raphatex/handheld-chip-8/README.md

# handheld-chip-8
on créé une console portable chip 8
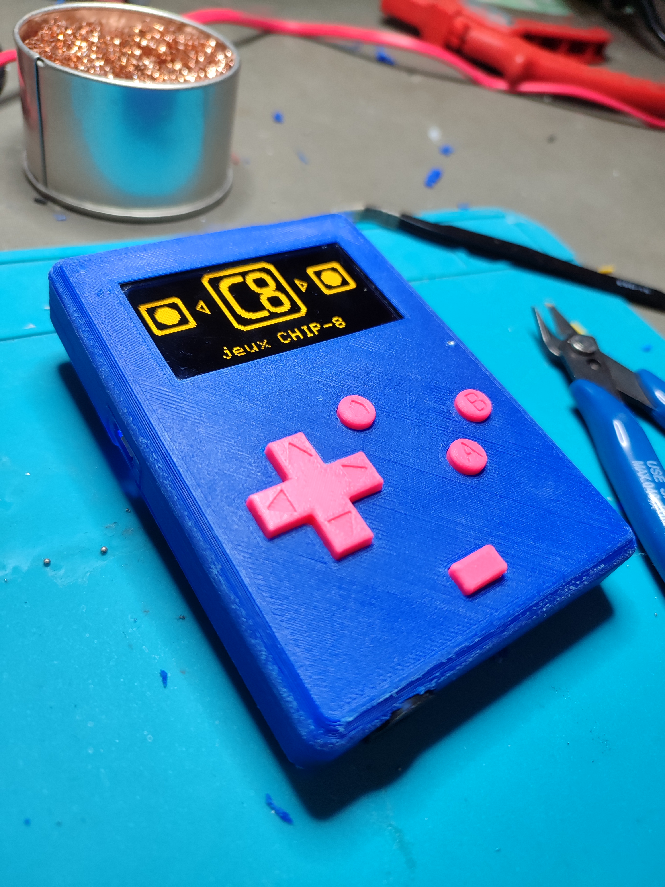
[picture p1: face_avant.jpg]

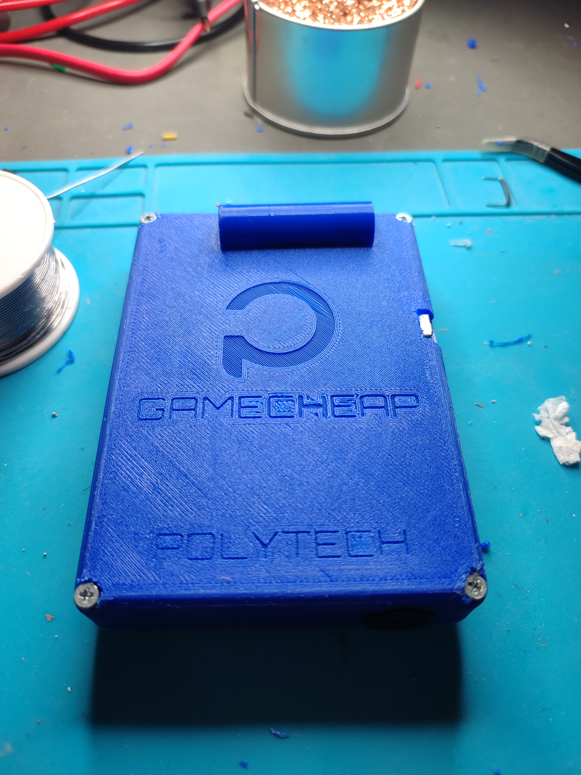
[picture p2: face_arriere.jpg]
