raphatex/handheld-chip-8/doc/photos/1706565870009.jpg

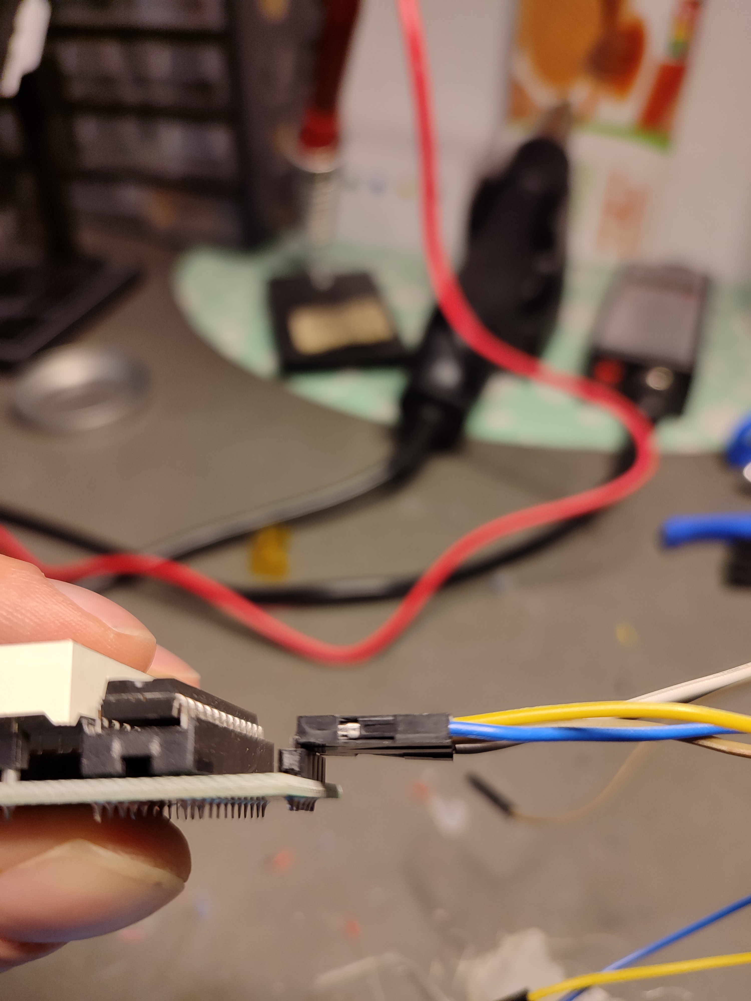
doc/photos/1706565870009.jpg
