raphatex/handheld-chip-8/doc/photos/1706565870017.jpg

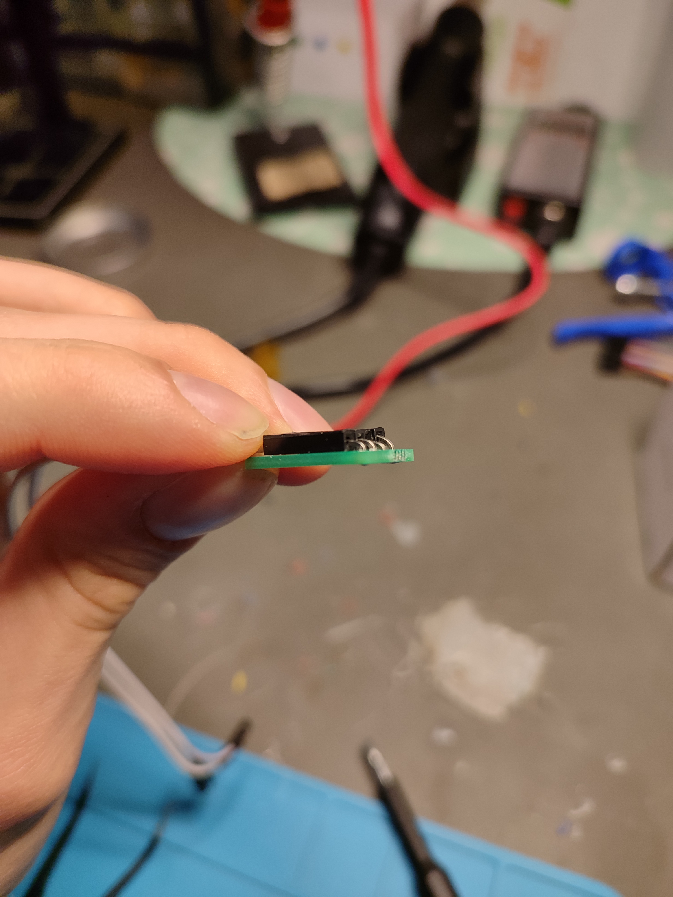
doc/photos/1706565870017.jpg
