raphatex/handheld-chip-8/doc/photos/1706565870035.jpg

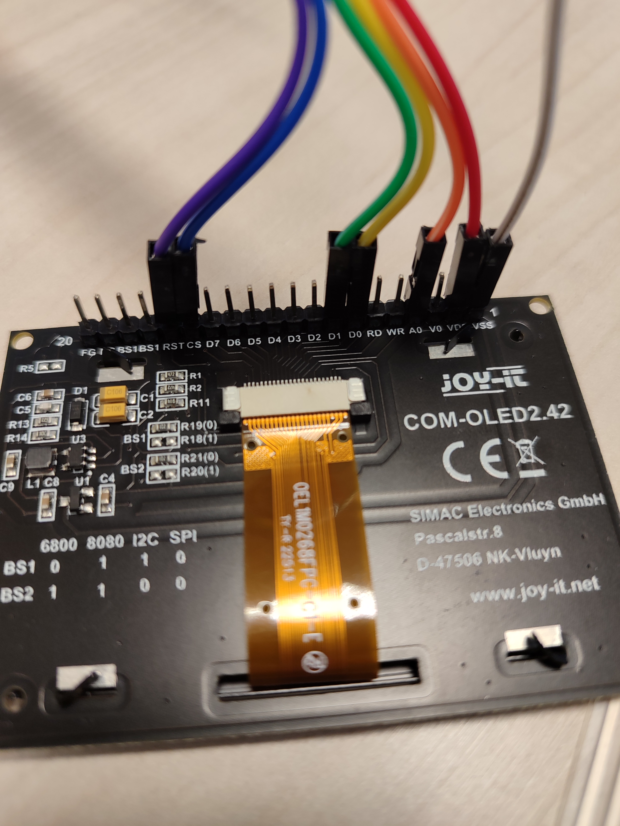
doc/photos/1706565870035.jpg
