raphatex/handheld-chip-8/doc/photos/1707742861026.jpg

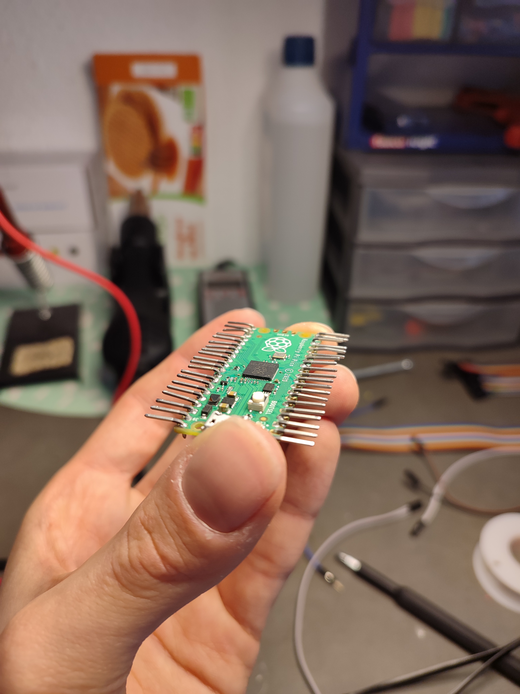
doc/photos/1707742861026.jpg
