raphatex/handheld-chip-8/doc/photos/1707742861034.jpg

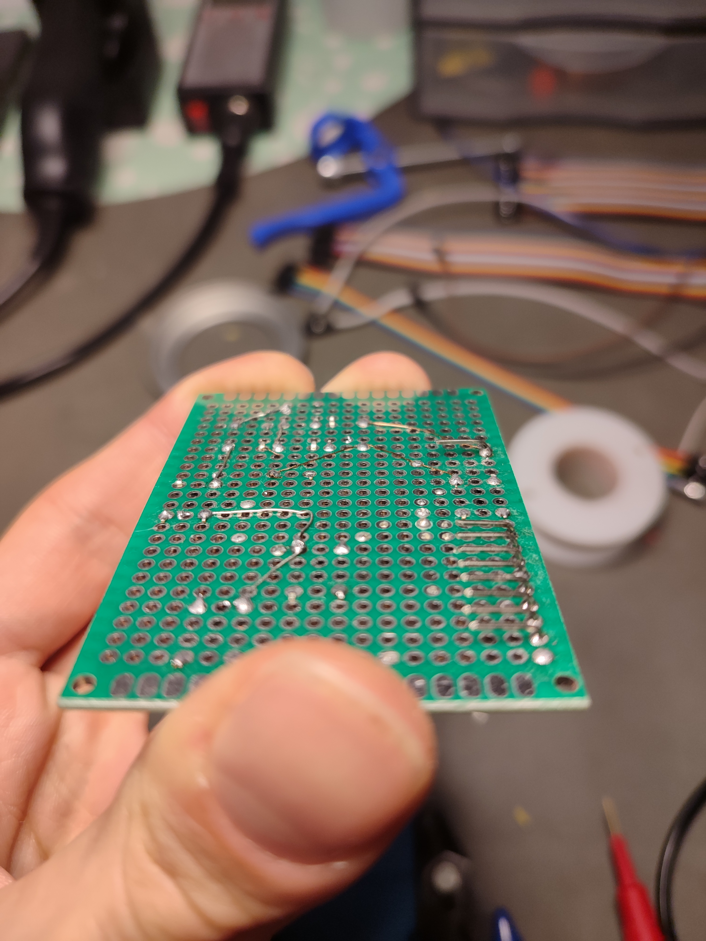
doc/photos/1707742861034.jpg
