raphatex/handheld-chip-8/doc/photos/1707742861042.jpg

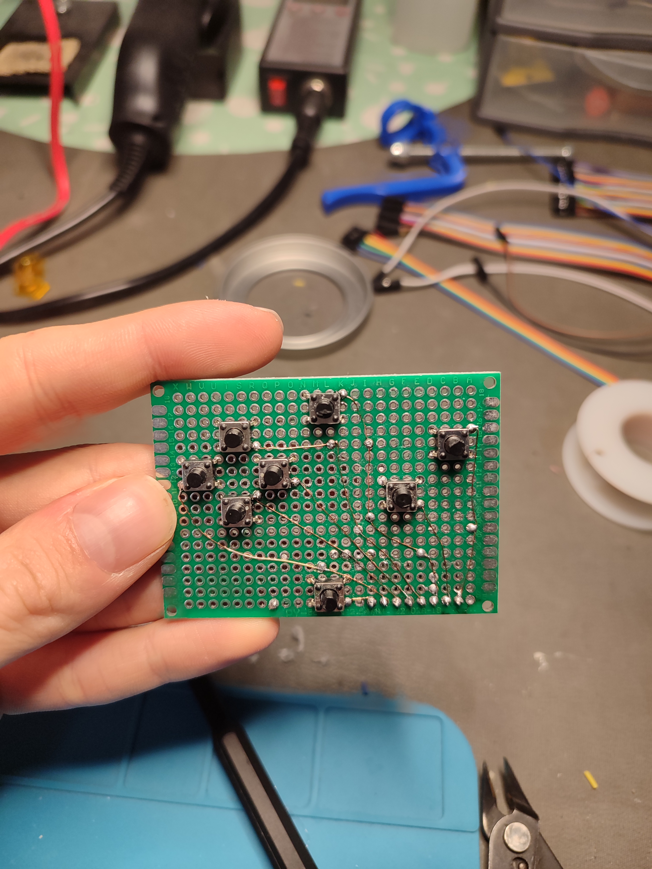
doc/photos/1707742861042.jpg
