raphatex/handheld-chip-8/doc/photos/1710105223419.jpg

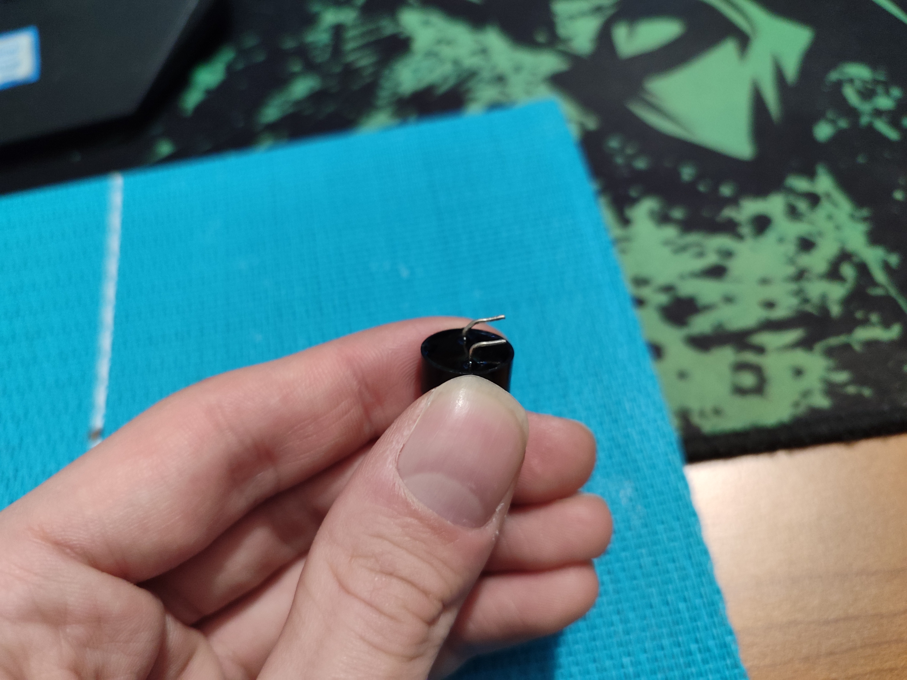
doc/photos/1710105223419.jpg
