raphatex/handheld-chip-8/doc/photos/1710105223430.jpg

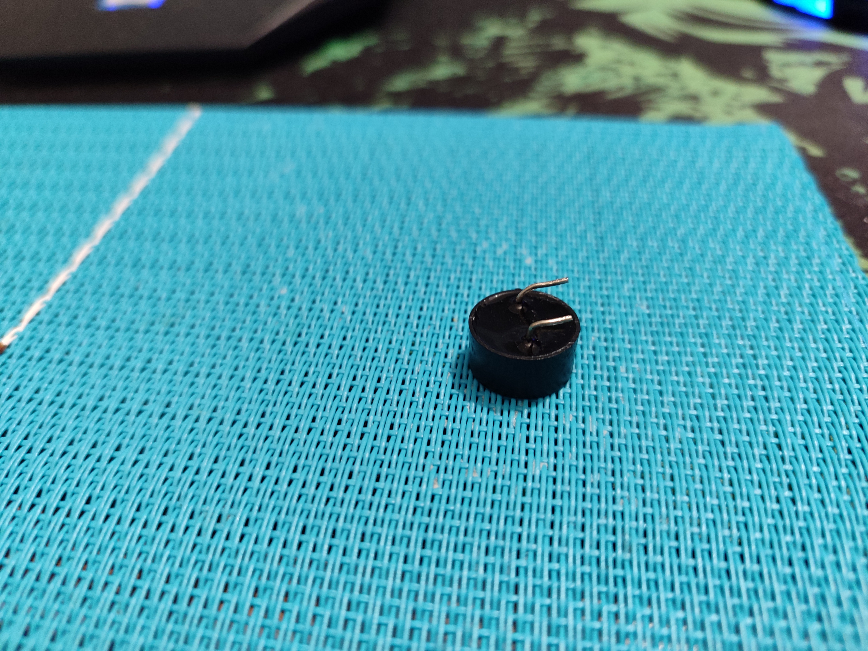
doc/photos/1710105223430.jpg
