raphatex/handheld-chip-8/doc/photos/1710105223459.jpg

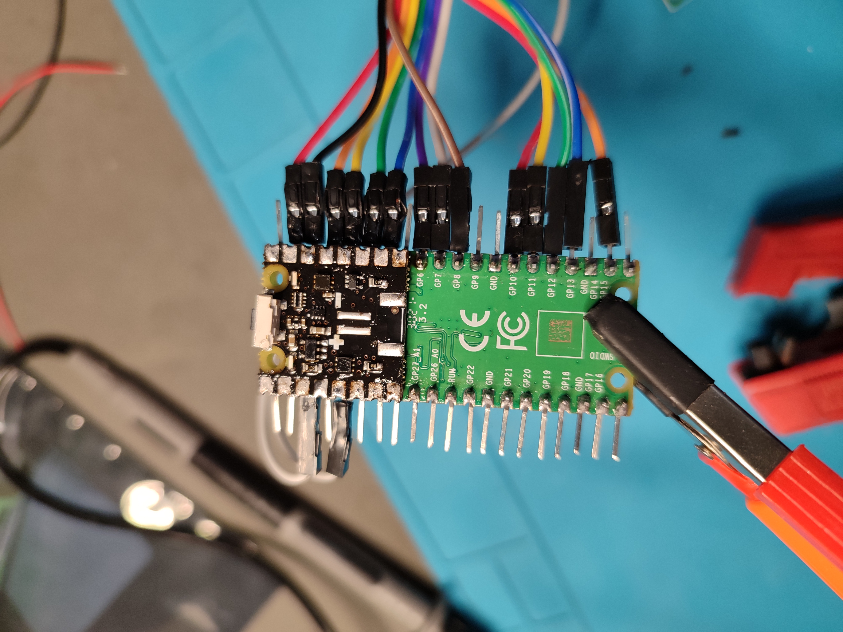
doc/photos/1710105223459.jpg
