raphatex/handheld-chip-8/doc/photos/1710794936792.jpg

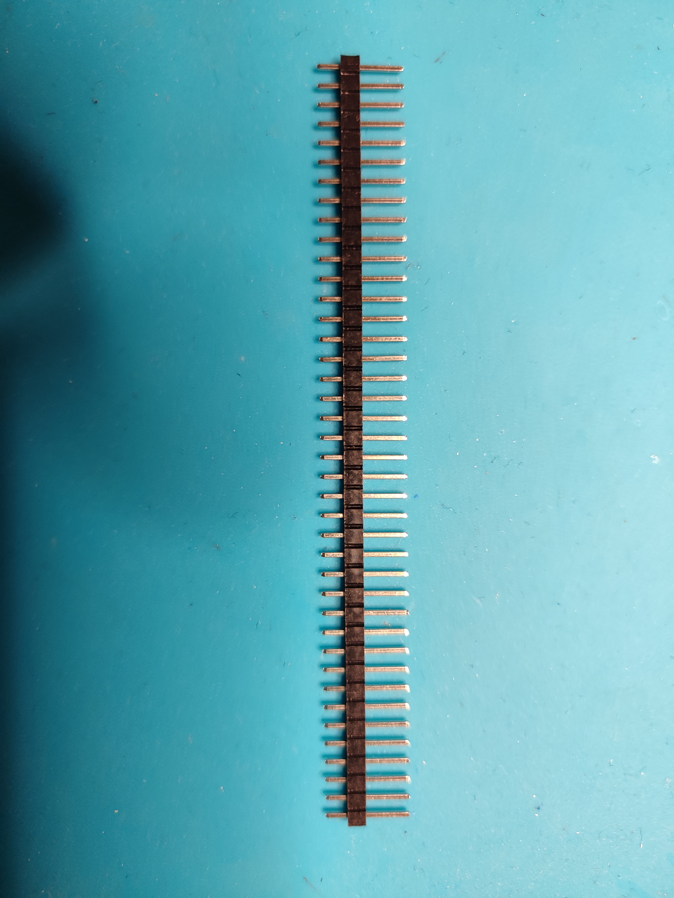
doc/photos/1710794936792.jpg
