raphatex/handheld-chip-8/doc/photos/1710794976683.jpg

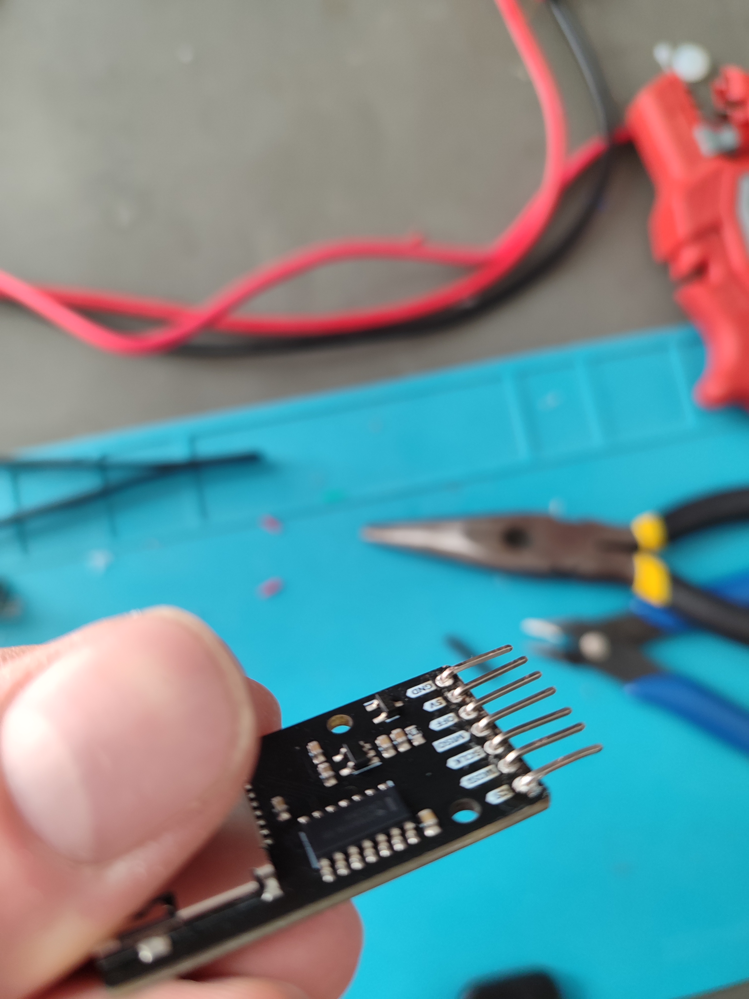
doc/photos/1710794976683.jpg
