raphatex/handheld-chip-8/doc/photos/1710794976693.jpg

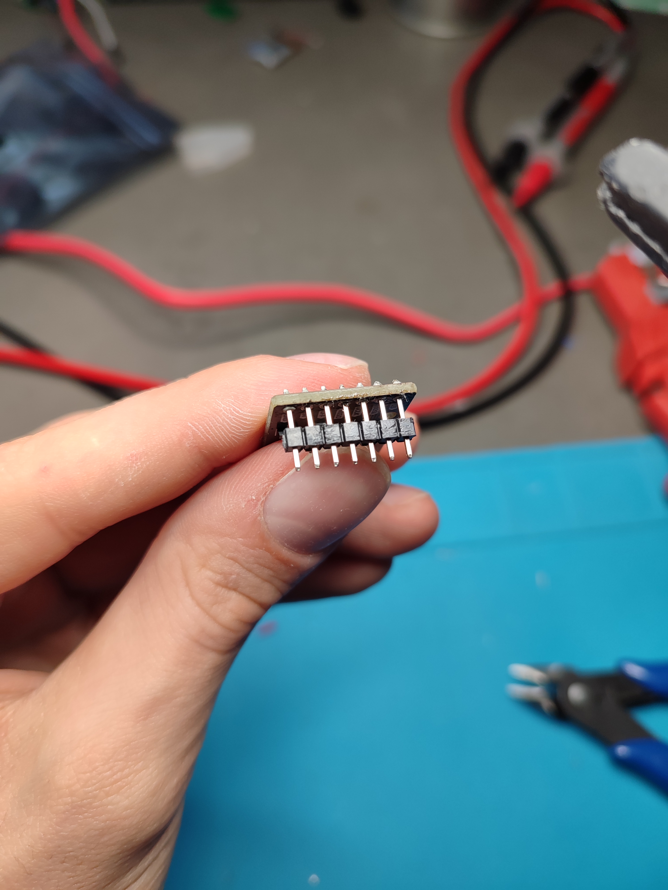
doc/photos/1710794976693.jpg
