raphatex/handheld-chip-8/doc/photos/1710794976715.jpg

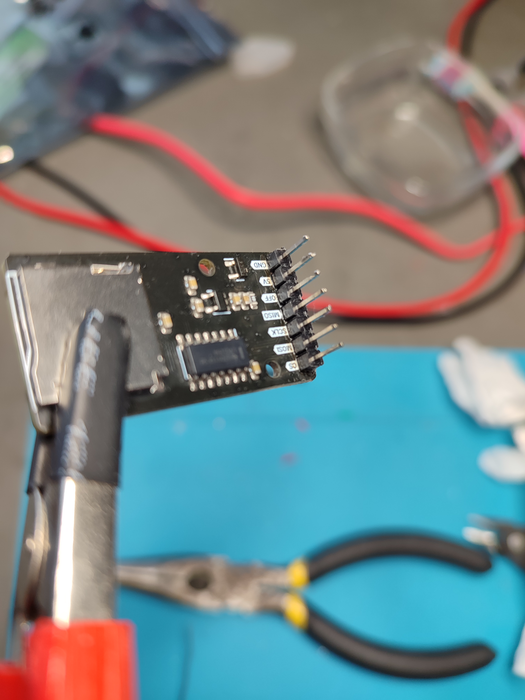
doc/photos/1710794976715.jpg
