raphatex/handheld-chip-8/doc/photos/1710795007688.jpg

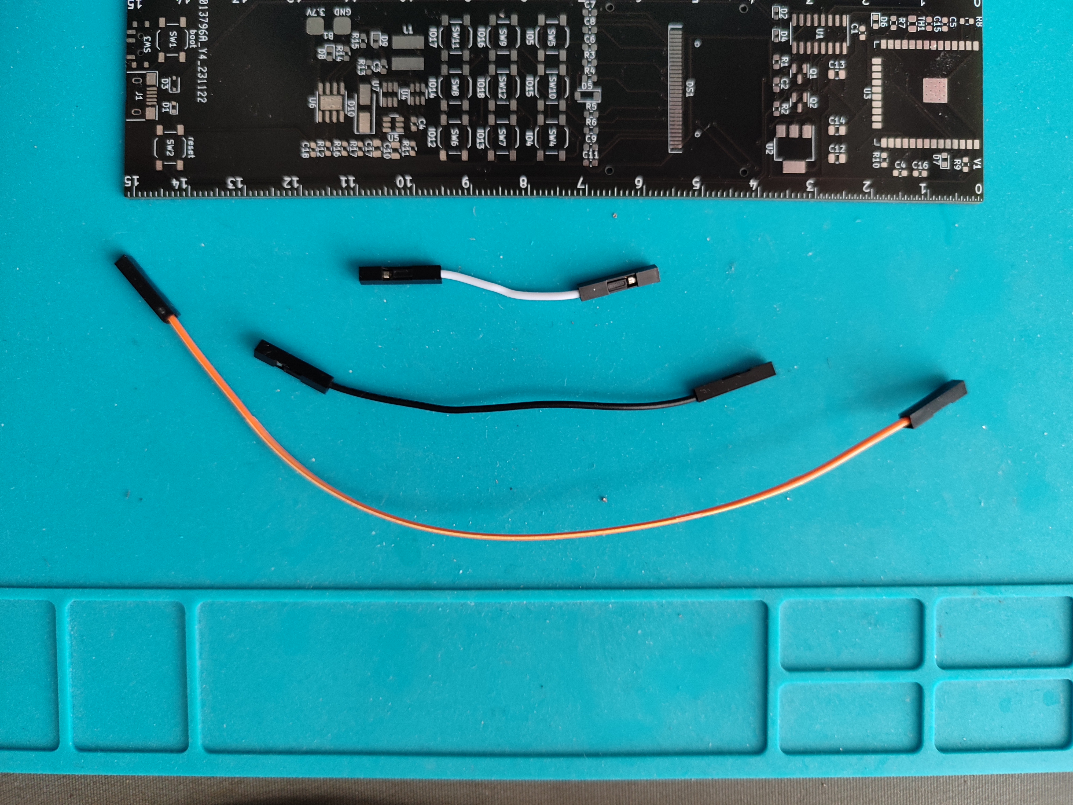
doc/photos/1710795007688.jpg
