raphatex/handheld-chip-8/doc/photos/1711299049130.jpg

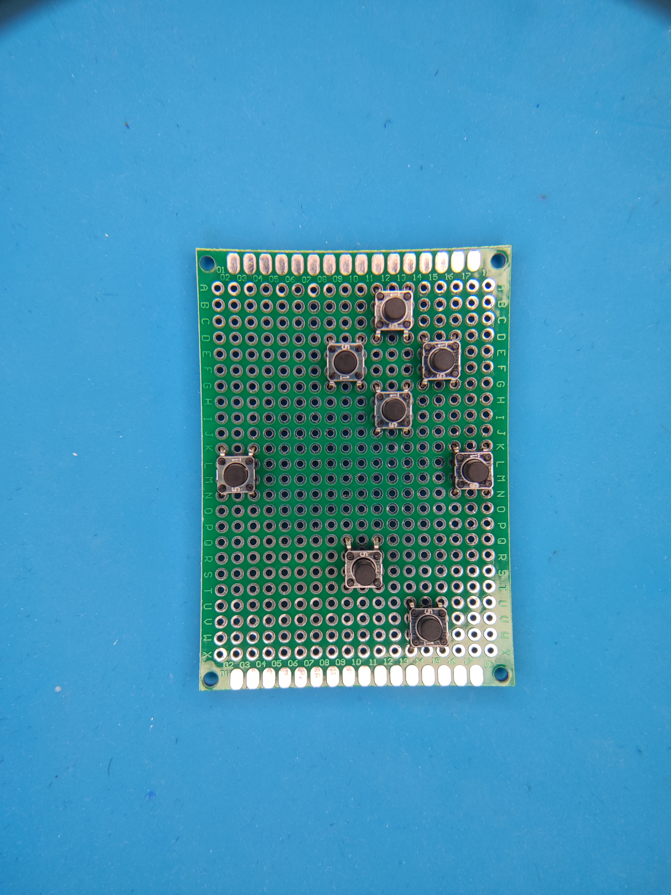
doc/photos/1711299049130.jpg
