raphatex/handheld-chip-8/doc/photos/1711313934900.jpg

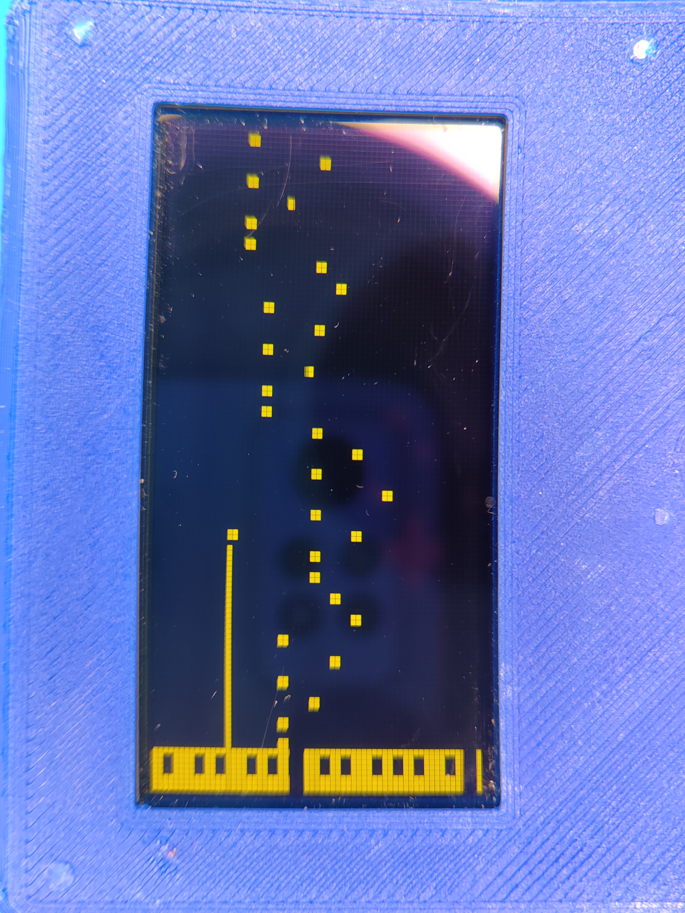
doc/photos/1711313934900.jpg
