raphatex/handheld-chip-8/doc/photos/1711471471531.jpg

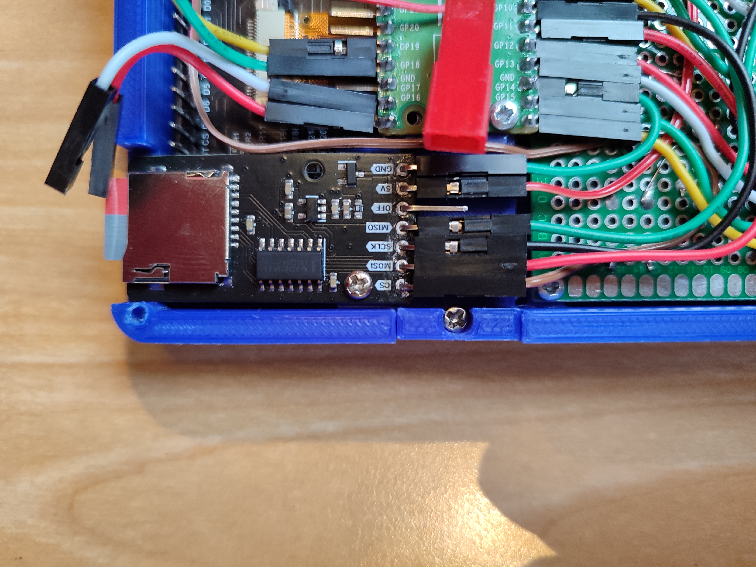
doc/photos/1711471471531.jpg
