raphatex/handheld-chip-8/doc/photos/1711471471543.jpg

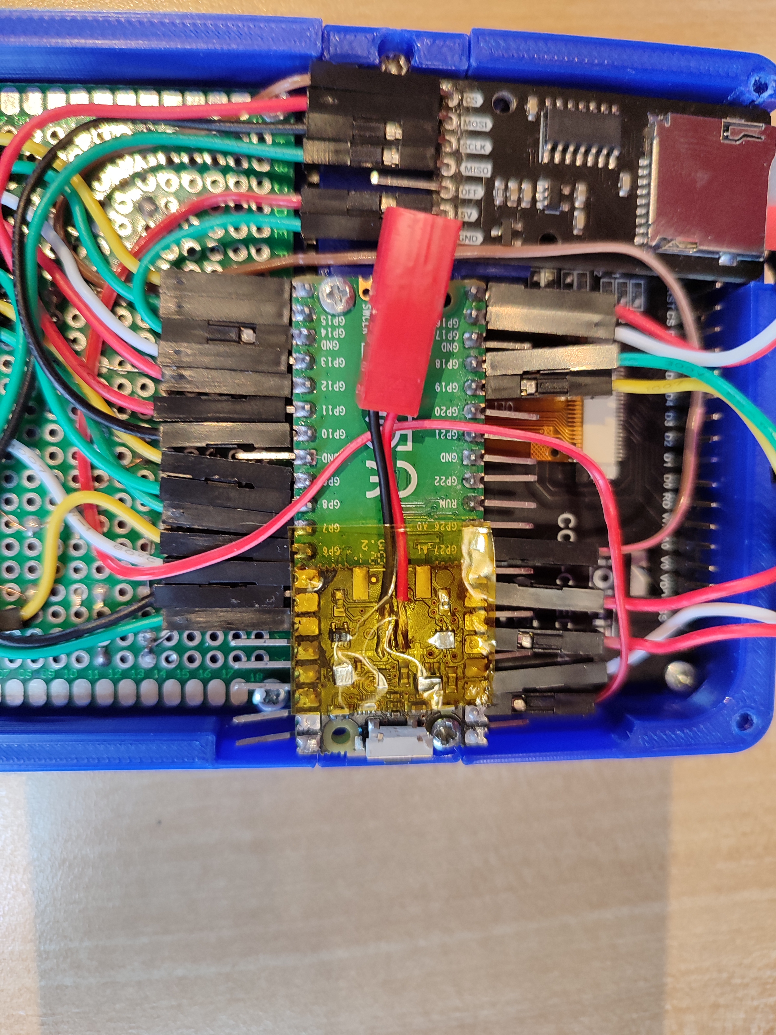
doc/photos/1711471471543.jpg
