raphatex/handheld-chip-8/doc/photos/1711471471553.jpg

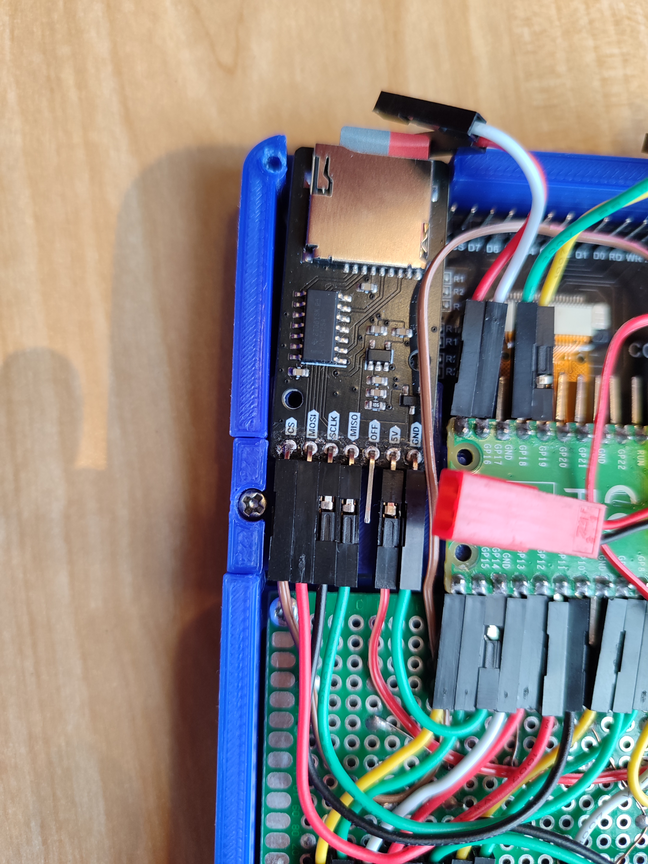
doc/photos/1711471471553.jpg
