raphatex/handheld-chip-8/doc/photos/1711471471571.jpg

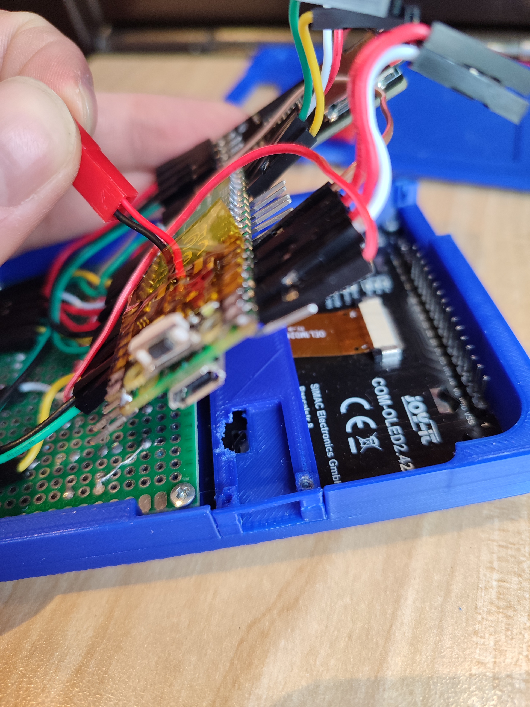
doc/photos/1711471471571.jpg
