raphatex/handheld-chip-8/doc/photos/Capture d'écran 2024-03-20 174903.png

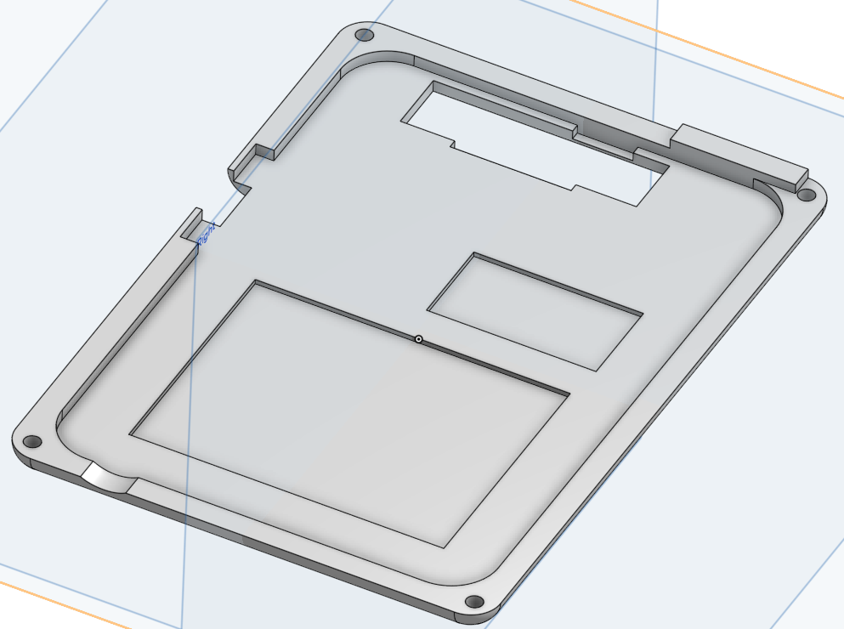
doc/photos/Capture d'écran 2024-03-20 174903.png
