raphatex/handheld-chip-8/doc/photos/schematic lipo shim.png

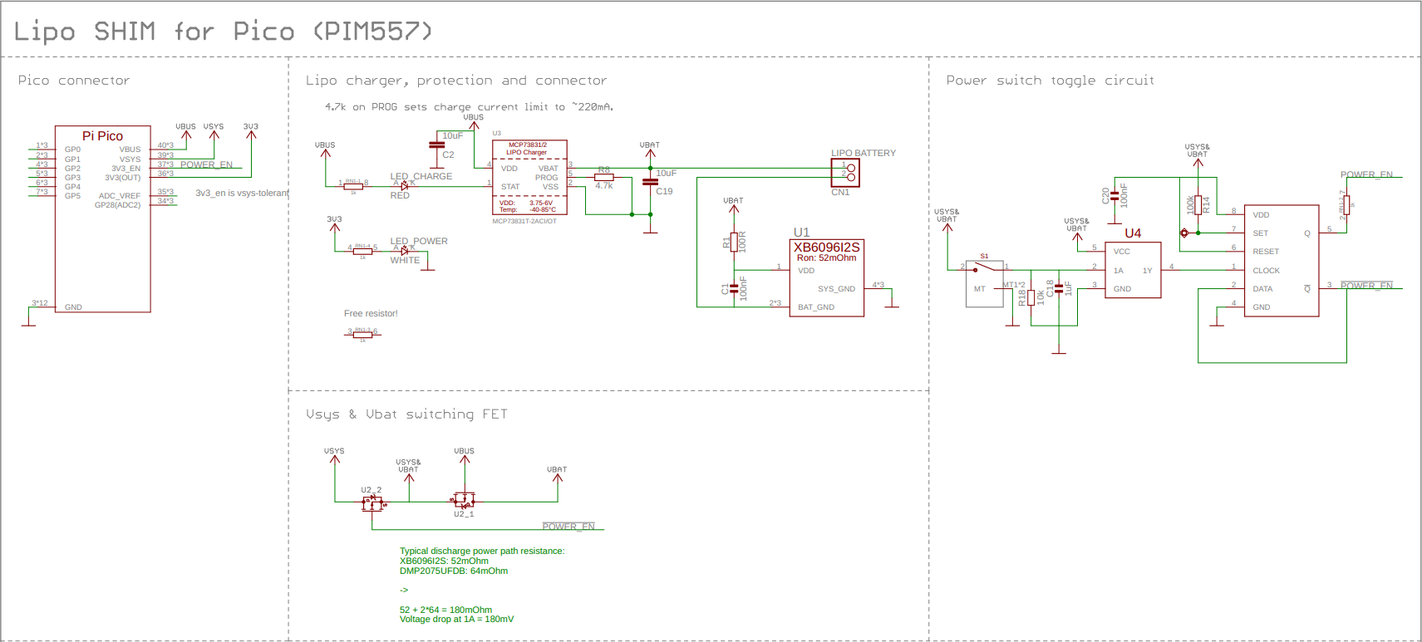
doc/photos/schematic lipo shim.png
