raphatex/handheld-chip-8/doc/photos/schematic pico.png

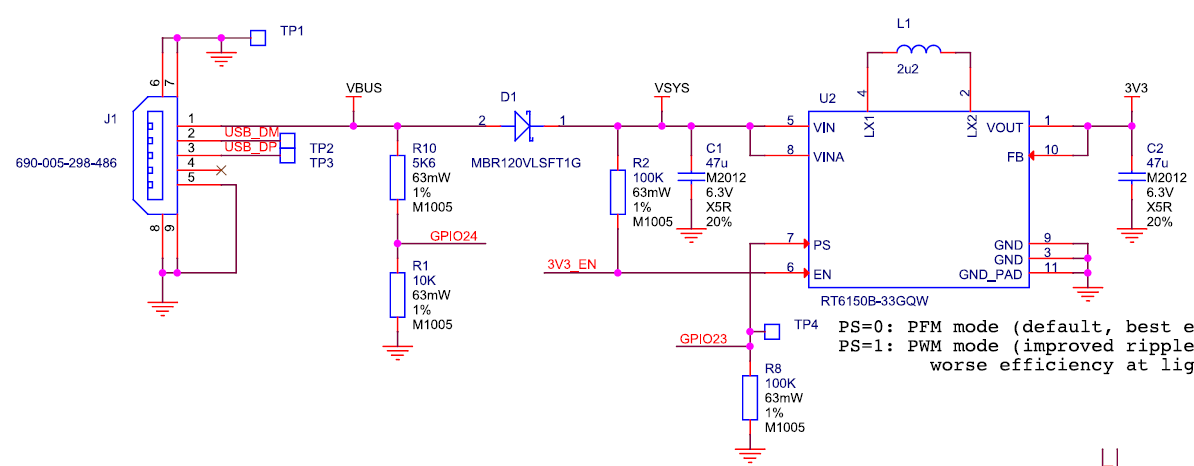
doc/photos/schematic pico.png
