raphatex/handheld-chip-8/doc/photos/schematic.png

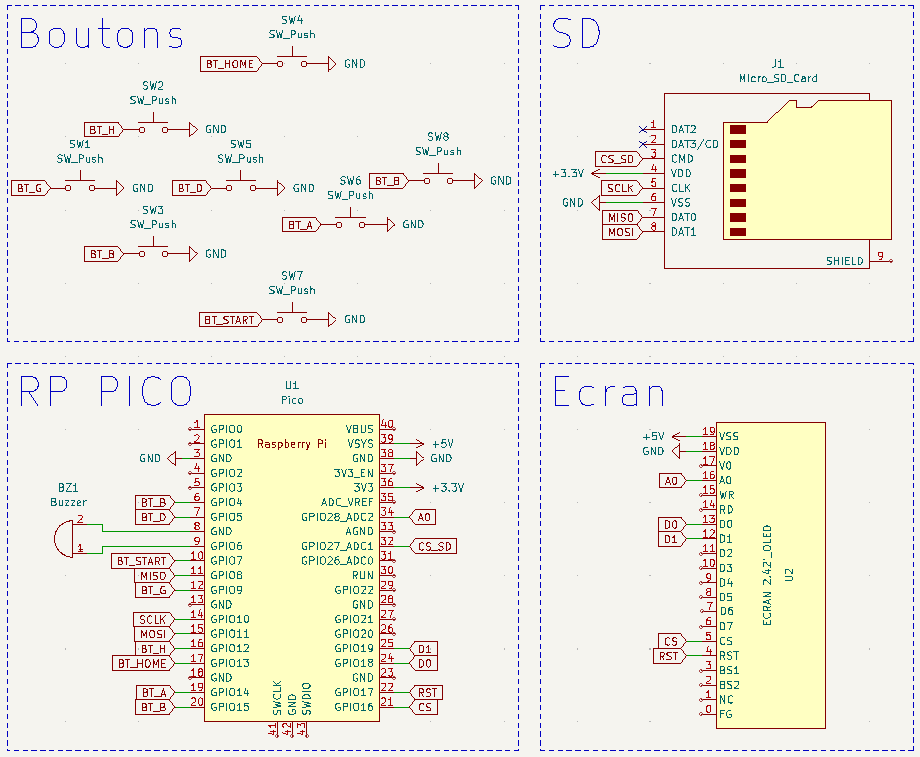
doc/photos/schematic.png
