raphatex/handheld-chip-8/modélisation 3d/V0.2/bottom.stl

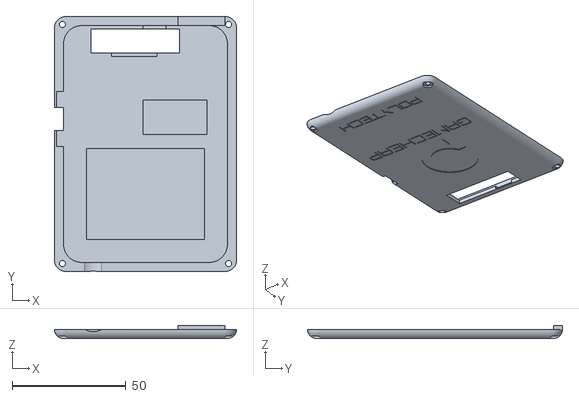
[picture p87: CAD file, 2024-03-24]
modélisation 3d/V0.2/bottom.stl
80.0 x 112.0 x 5.70
