raphatex/handheld-chip-8/modélisation 3d/V0.2/top.stl

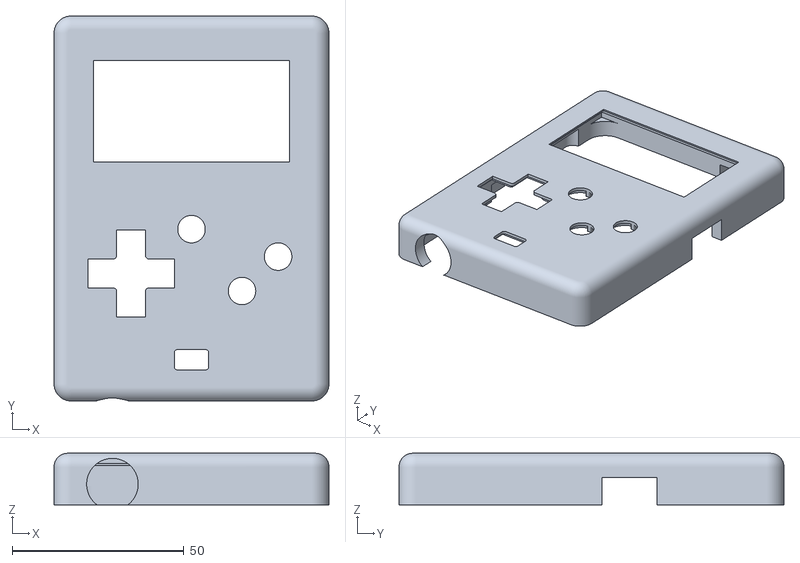
[picture p88: CAD file, 2024-03-24]
modélisation 3d/V0.2/top.stl
80.0 x 112.0 x 15.0
