raphatex/handheld-chip-8/modélisation 3d/V0.2/bouton home.stl

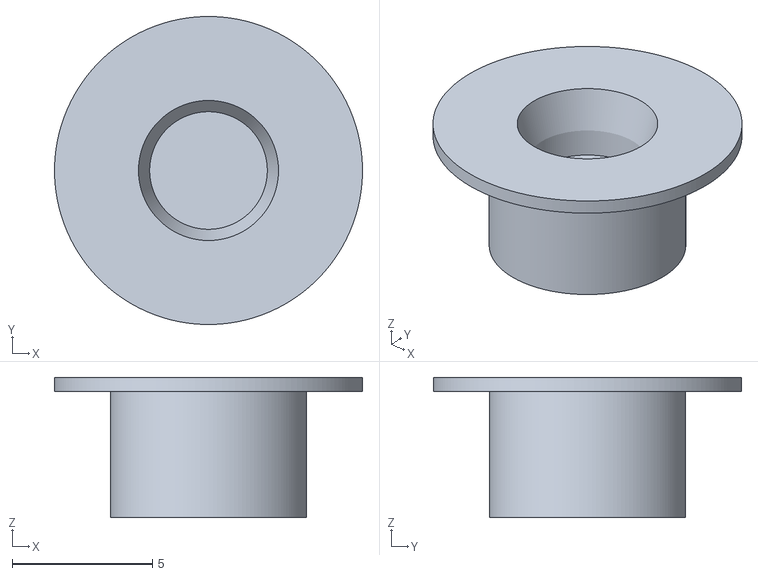
[picture p90: CAD file, 2024-03-24]
modélisation 3d/V0.2/bouton home.stl
11.0 x 11.0 x 5.00
