raphatex/handheld-chip-8/modélisation 3d/V0.2/cover.stl

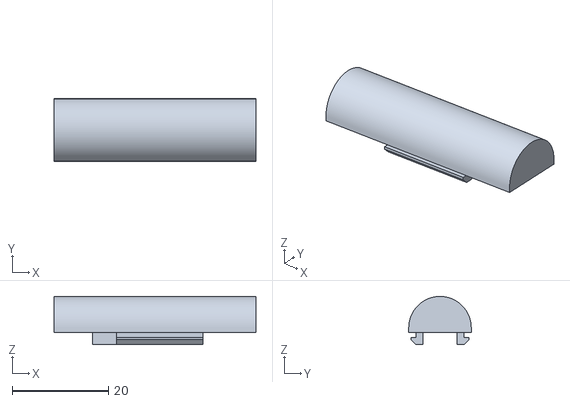
[picture p91: CAD file, 2024-03-24]
modélisation 3d/V0.2/cover.stl
42.0 x 13.0 x 10.0
