raphatex/handheld-chip-8/modélisation 3d/V0.2/start.stl

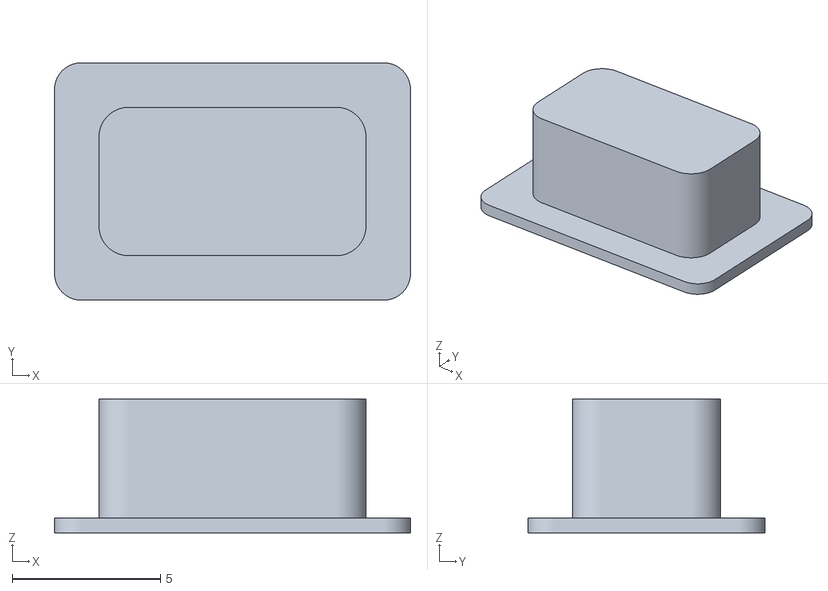
[picture p92: CAD file, 2024-03-24]
modélisation 3d/V0.2/start.stl
12.0 x 8.00 x 4.50
