raphatex/handheld-chip-8/modélisation 3d/V0.2/support pico.stl

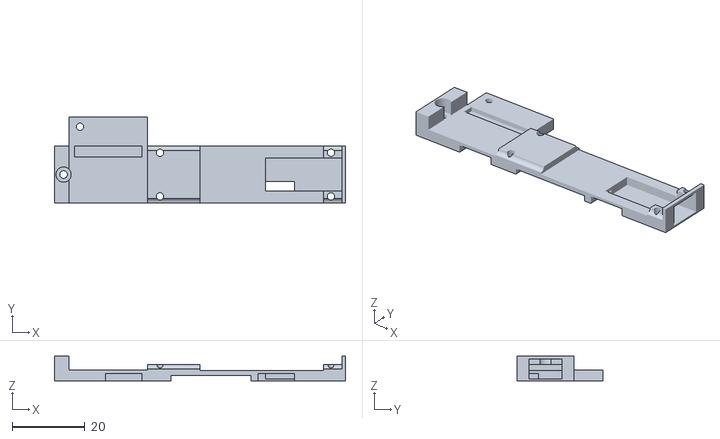
[picture p93: CAD file, 2024-03-24]
modélisation 3d/V0.2/support pico.stl
80.0 x 23.7 x 6.80
