raphatex/handheld-chip-8/modélisation 3d/V0.2/croix.stl

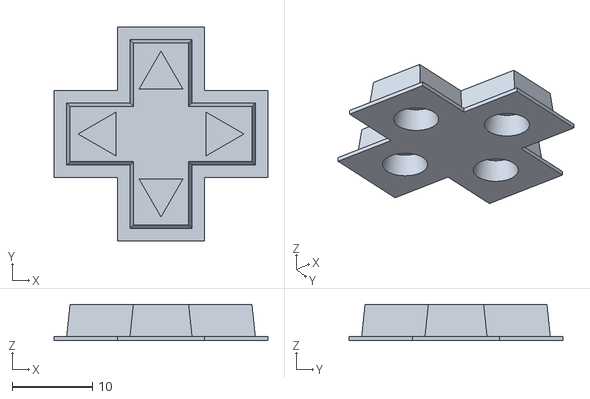
[picture p94: CAD file, 2024-03-24]
modélisation 3d/V0.2/croix.stl
26.7 x 26.7 x 4.50
