raphatex/handheld-chip-8/modélisation 3d/V0/top boitier.stl

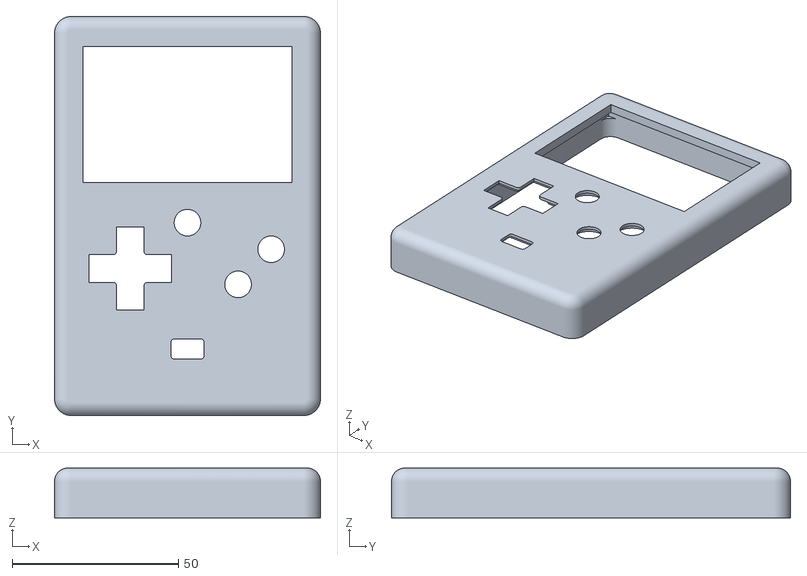
[picture p95: CAD file, 2024-03-24, an earlier design]
modélisation 3d/V0/top boitier.stl
80.0 x 120.0 x 15.0
