raphatex/handheld-chip-8/modélisation 3d/V0/start.stl

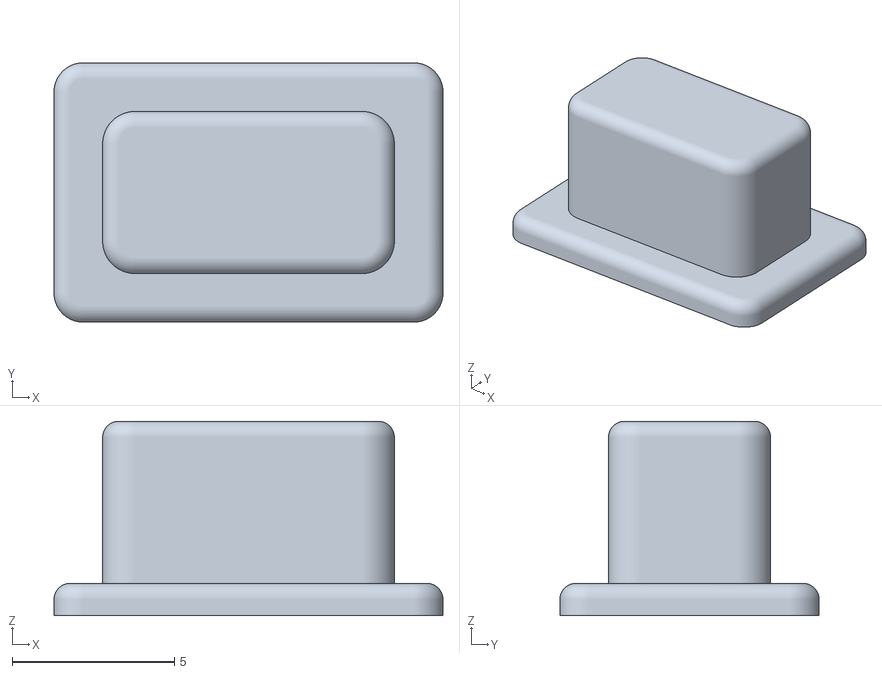
[picture p96: CAD file, 2024-03-24, an earlier design]
modélisation 3d/V0/start.stl
12.0 x 8.00 x 6.00
