raphatex/handheld-chip-8/modélisation 3d/V0/croix.stl

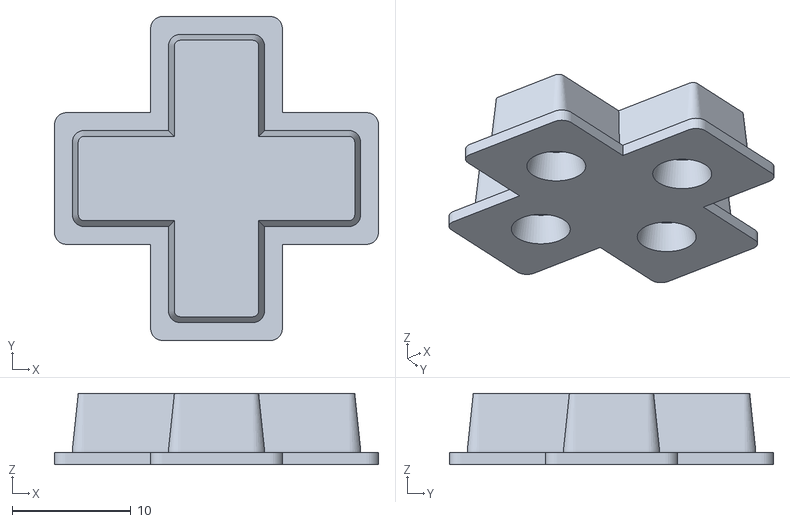
[picture p97: CAD file, 2024-03-24, an earlier design]
modélisation 3d/V0/croix.stl
27.3 x 27.3 x 6.00
