raphatex/handheld-chip-8/modélisation 3d/V0/bouton A-B.stl

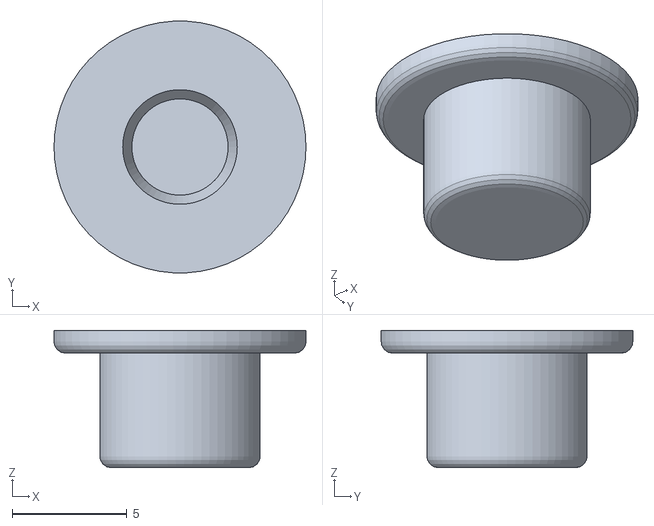
[picture p99: CAD file, 2024-03-24, an earlier design]
modélisation 3d/V0/bouton A-B.stl
11.0 x 11.0 x 6.00
