raphatex/handheld-chip-8/modélisation 3d/V0.1/croix test.stl

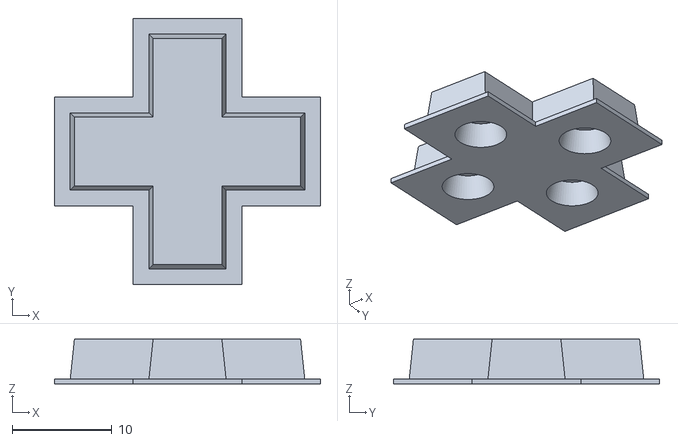
[picture p100: CAD file, 2024-03-24, an earlier design]
modélisation 3d/V0.1/croix test.stl
26.7 x 26.7 x 4.50
