raphatex/handheld-chip-8/(list of files, cad)

Other CAD files:
modélisation 3d/V0.2/B.stl
modélisation 3d/V0.1/home.stl
modélisation 3d/V0.1/A et B.stl
modélisation 3d/V0.1/console top.stl
modélisation 3d/V0.1/croix.stl
modélisation 3d/V0/bouton home.stl
