raphatex/handheld-chip-8/doc/ecran/Comment installer la librairie.docx

Comment installer la librairie pour l’écran ?

1°) télécharger la librairie depuis le github :

https://github.com/rdagger/micropython-ssd1309

2°) ouvrir le fichier « ssd1309.py » et le copier sur le Raspberry.

3°) ouvrir le fichier « xglcd_font.py » et le copier sur le Raspberry.

4°) Ouvir le fichier « demo_shapes.py » et le copier sur le Raspberry.

5°)

spi = SPI(1, baudrate=10000000, sck=Pin(A), mosi=Pin(B))

display = Display(spi, dc=Pin(C), cs=Pin(D), rst=Pin(E))

Modifier les valeurs A, B, C, D, E avec les pins correspondants
