raphatex/handheld-chip-8/fichiers rapsberry PI PICO/pinout.py

from machine import Pin

# buzzer :
PIN_BUZZ = Pin(6)

# ecran :
SPI_ID = 0
PIN_A0 = Pin(28)
PIN_D0 = Pin(18)
PIN_D1 = Pin(19)
PIN_CS = Pin(16)
PIN_RST = Pin(17)

# sd :
SD_READER = 1
SD_SPI_ID = 1
SD_SCLK = Pin(10)
SD_MOSI = Pin(11)
SD_MISO = Pin(8)
SD_CS = Pin(27)
