raphatex/handheld-chip-8/(commit log)

2024-04-09 New pico files
    [jeux.xlsx, settings.cfg]
2024-04-11 réorganisation
    [jeux.xlsx, settings.cfg]
2024-04-16 suppression de choses inutiles
